pinkmosss/touchsurface_cv/hardware/bom_touch_rack.csv

Designator | Footprint | Quantity | Value | LCSC Part #
CN1 | FPC-SMD_22P-P0.50_FH55-22S-0.5SH | 1 | FH55-22S-0.5SH | C5182313
