pinkmosss/touchsurface_cv/data/test1_summary.csv

condition | n_seconds | mean_fps | std_fps | min_fps | max_fps
untouched | 61 | 50.57377049180328 | 1.81162005208453 | 37 | 51
touched | 61 | 50.36065573770492 | 1.8076945435668967 | 37 | 51
