pinkmosss/touchsurface_cv/data/test1_touched.csv

FPS | 37
FPS | 50
FPS | 50
FPS | 51
FPS | 51
FPS | 51
FPS | 51
FPS | 50
FPS | 50
FPS | 50
FPS | 51
FPS | 51
FPS | 51
FPS | 51
FPS | 50
FPS | 51
FPS | 51
FPS | 51
FPS | 50
FPS | 50
FPS | 50
FPS | 51
FPS | 51
FPS | 51
FPS | 51
FPS | 51
FPS | 50
FPS | 51
FPS | 51
FPS | 51
FPS | 50
FPS | 50
FPS | 50
FPS | 51
FPS | 51
FPS | 51
FPS | 51
FPS | 50
FPS | 50
FPS | 51
FPS | 50
FPS | 51
FPS | 51
FPS | 50
FPS | 50
FPS | 50
FPS | 51
FPS | 51
FPS | 51
FPS | 50
FPS | 50
FPS | 51
FPS | 50
FPS | 51
FPS | 51
FPS | 51
FPS | 50
FPS | 50
FPS | 50
FPS | 51
FPS | 51
