pinkmosss/touchsurface_cv/data/test2_latency.csv

LATENCY_US | 820
LATENCY_US | 812
LATENCY_US | 820
LATENCY_US | 820
LATENCY_US | 820
LATENCY_US | 820
LATENCY_US | 820
LATENCY_US | 816
LATENCY_US | 820
LATENCY_US | 1272
LATENCY_US | 820
LATENCY_US | 816
LATENCY_US | 812
LATENCY_US | 816
LATENCY_US | 816
LATENCY_US | 816
LATENCY_US | 812
LATENCY_US | 820
LATENCY_US | 812
LATENCY_US | 820
LATENCY_US | 1280
LATENCY_US | 816
LATENCY_US | 816
LATENCY_US | 820
LATENCY_US | 820
LATENCY_US | 820
LATENCY_US | 820
LATENCY_US | 820
LATENCY_US | 816
LATENCY_US | 812
LATENCY_US | 820
LATENCY_US | 1268
LATENCY_US | 820
LATENCY_US | 816
LATENCY_US | 1284
LATENCY_US | 976
LATENCY_US | 976
LATENCY_US | 976
LATENCY_US | 976
LATENCY_US | 972
LATENCY_US | 1284
LATENCY_US | 1432
LATENCY_US | 980
LATENCY_US | 976
LATENCY_US | 968
LATENCY_US | 976
LATENCY_US | 976
LATENCY_US | 1288
LATENCY_US | 976
LATENCY_US | 980
LATENCY_US | 980
LATENCY_US | 980
LATENCY_US | 1432
LATENCY_US | 980
LATENCY_US | 1284
LATENCY_US | 1288
LATENCY_US | 976
LATENCY_US | 980
LATENCY_US | 1284
LATENCY_US | 976
LATENCY_US | 1288
LATENCY_US | 980
LATENCY_US | 980
LATENCY_US | 1428
LATENCY_US | 976
LATENCY_US | 980
LATENCY_US | 1288
LATENCY_US | 1292
LATENCY_US | 976
LATENCY_US | 1288
LATENCY_US | 980
LATENCY_US | 980
LATENCY_US | 984
LATENCY_US | 1436
LATENCY_US | 980
LATENCY_US | 980
LATENCY_US | 972
LATENCY_US | 984
LATENCY_US | 980
LATENCY_US | 980
LATENCY_US | 984
LATENCY_US | 1284
LATENCY_US | 976
LATENCY_US | 1292
LATENCY_US | 1432
LATENCY_US | 980
LATENCY_US | 976
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
LATENCY_US | 976
LATENCY_US | 976
LATENCY_US | 972
LATENCY_US | 1436
LATENCY_US | 976
LATENCY_US | 972
LATENCY_US | 972
LATENCY_US | 976
LATENCY_US | 976
LATENCY_US | 976
LATENCY_US | 976
LATENCY_US | 972
LATENCY_US | 972
LATENCY_US | 976
LATENCY_US | 1436
LATENCY_US | 976
LATENCY_US | 976
LATENCY_US | 976
LATENCY_US | 976
LATENCY_US | 972
LATENCY_US | 972
LATENCY_US | 976
LATENCY_US | 972
LATENCY_US | 972
LATENCY_US | 972
LATENCY_US | 1428
LATENCY_US | 976
LATENCY_US | 976
LATENCY_US | 972
LATENCY_US | 972
LATENCY_US | 972
LATENCY_US | 1132
LATENCY_US | 816
LATENCY_US | 816
LATENCY_US | 820
LATENCY_US | 1276
LATENCY_US | 820
LATENCY_US | 820
LATENCY_US | 816
LATENCY_US | 820
LATENCY_US | 812
LATENCY_US | 820
LATENCY_US | 812
LATENCY_US | 820
LATENCY_US | 812
LATENCY_US | 820
LATENCY_US | 1280
LATENCY_US | 816
LATENCY_US | 816
LATENCY_US | 820
LATENCY_US | 820
LATENCY_US | 820
LATENCY_US | 820
LATENCY_US | 816
LATENCY_US | 820
LATENCY_US | 816
LATENCY_US | 820
LATENCY_US | 1272
LATENCY_US | 820
LATENCY_US | 1288
LATENCY_US | 976
LATENCY_US | 980
LATENCY_US | 976
LATENCY_US | 976
LATENCY_US | 980
LATENCY_US | 1292
LATENCY_US | 1292
LATENCY_US | 1436
LATENCY_US | 980
LATENCY_US | 984
LATENCY_US | 972
LATENCY_US | 980
LATENCY_US | 980
