pinkmosss/touchsurface_cv/data/test3_point_bottomleft.csv

TOUCH | 0 | 1
TOUCH | 0 | 1
TOUCH | 0 | 1
TOUCH | 0 | 1
TOUCH | 0 | 1
TOUCH | 0 | 1
TOUCH | 0 | 1
TOUCH | 0 | 1
TOUCH | 0 | 1
TOUCH | 0 | 1
TOUCH | 0 | 1
TOUCH | 0 | 1
