pinkmosss/touchsurface_cv/hardware/component-pad.kicad_pcb

## KiCad design hardware/component-pad.kicad_pcb (2026-09-29)

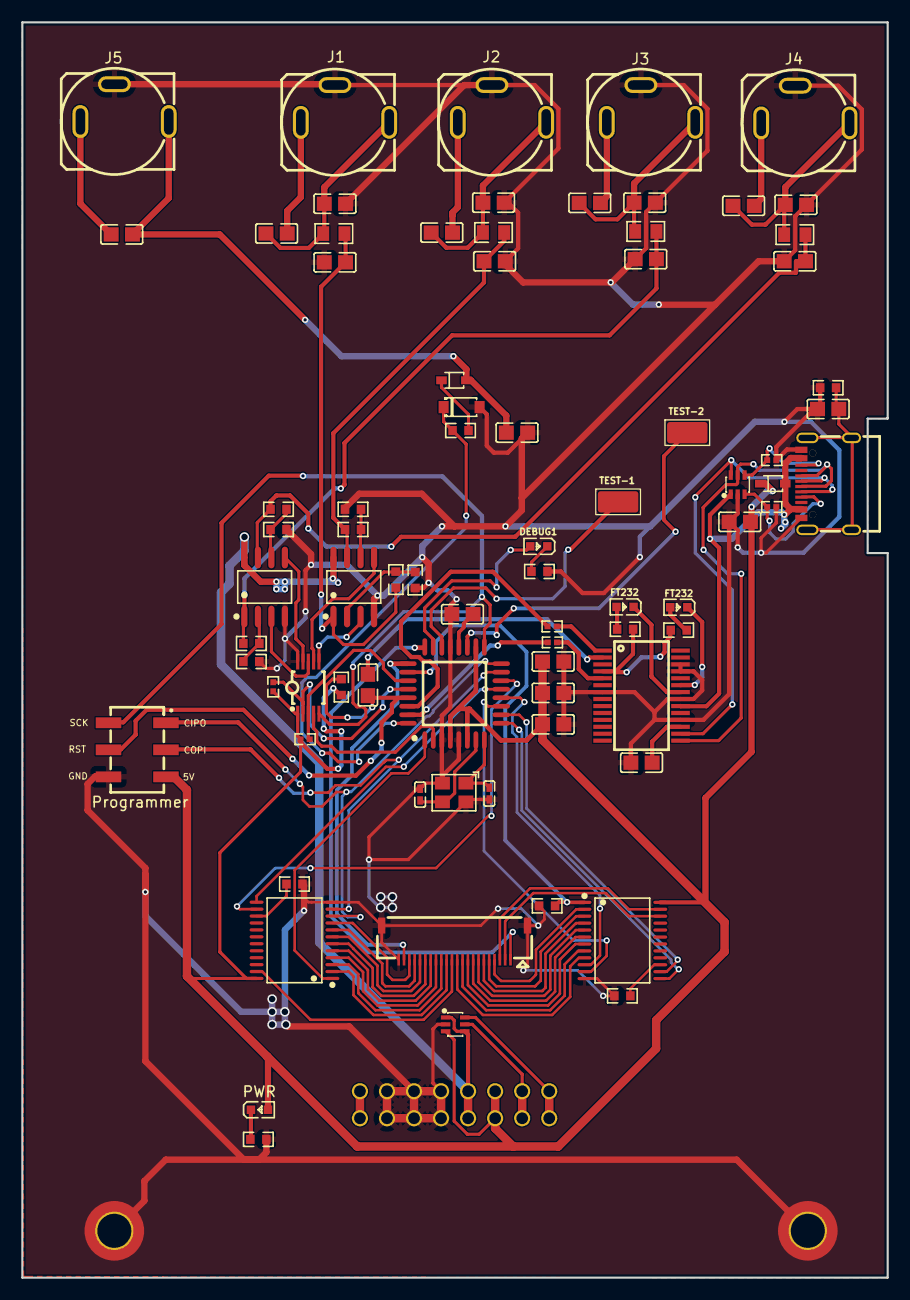
[picture p1: board component-pad.kicad_pcb from above]

Board: 2 copper layers, 81.3 x 117.9 mm, 80 parts (1 on the bottom side), 93 nets.

Parts:
C1, C5, C8, C9, C11, C12, C14, C16, C18, C19, C20, C21, C22, C23, C24: 100nF; C0805
C2, C6, C7, C10, C13, C15, C17: 10uF; C0805
C3, C4: 15pf; C0402
CN1: FH55-22S-0.5SH; FPC-SMD_22P-P0.50_FH55-22S-0.5SH
CN2: PM254-2-03-S-8.5; HDR-SMD_6P-P2.54-V-F-R2-C3-LS7.0
D1, D2: SMF05CT1G; SOT-363_L2.0-W1.3-P0.65-LS2.1-BR
D3, D4: 1N5819WS; SOD-323_L1.8-W1.3-LS2.5-RD
J1, J2, J3, J4, J5: PJ-3411; AUDIO-TH_PJ-3411
LED1, LED2: Red; LED0603-RD
LED3, LED4: KT-0603R; LED0603-RD
P1: Eurorack Power; IDC-TH_16P-P2.54_C3406
R1: 1M; R0603
R2, R3: 5.1k; R0402
R4, R5, R30, R31: 330; R0603
R6, R9, R10, R11, R12, R13, R14, R15, R16, R17, R18, R24: 10k; R0603
R7, R8: 4.7k; R0402
R19, R20, R21, R22: 100; R0805
R27, R28: 1k; R0402
R29: 100k; R0603
TEST-1, TEST-2: TestPoint_Keystone_5019_Miniature
U1: MCP4728-E/UN; MSOP-10_L3.0-W3.0-P0.50-LS5.0-TL
U2: ATMEGA328-AU; TQFP-32_L7.0-W7.0-P0.80-LS9.0-BL
U3: FT232RNL-REEL; SSOP28_L10.2-W5.3-P0.65-LS7.8-BL
U4, U5: CD74HC4067SM96; SSOP-24_L8.1-W5.3-P0.65-LS7.8-BL
U6, U7: MCP6002T-I/SN; SOIC-8_L4.9-W3.9-P1.27-LS6.0-BL
USB1: TYPE-C16PIN; USB-C-SMD_TYPE-C16PIN
X1: X322516MLB4SI; OSC-SMD_4P-L3.2-W2.5-BL
ZD1: BZT52C5V1; SOD-123_L2.8-W1.8-LS3.7-RD

Connections:
AVR_RST: C5.1, CN2.5, R6.1, U2.29 (~PC6(RESET/PCINT14))
CAP1: CN1.1, U2.24 (PC1(ADC1/PCINT9))
CAP2: CN1.21, U2.25 (PC2(ADC2/PCINT10))
CC_1: D1.3, R3.1, USB1.A5 (CC1)
CC_2: D1.4, R2.1, USB1.B5 (CC2)
CIPO: CN2.1, U2.16 ((PCINT4/MISO)PB4), U4.10 (S0)
COPI: CN2.2, U2.15 ((PCINT3/OC2A/MOSI)PB3), U4.11 (S1)
DAC_LDAC: U1.4 (~LDAC), U2.2 ((PCINT20/XCK/T0)PD4)
DAC_OUT1: U1.6 (VOUTA), U6.3 (+INA)
DAC_OUT2: U1.7 (VOUTB), U6.5 (+INB)
DAC_OUT3: U1.8 (VOUTC), U7.3 (+INA)
DAC_OUT4: U1.9 (VOUTD), U7.5 (+INB)
DAC_RDY: CN2.6, U1.5 (RDY/~BSY), U2.17 (PB5(SCK/PCINT5))
DAC_SCL: R7.1, U1.2 (SCL), U2.28 (PC5(ADC5/SCL/PCINT13))
DAC_SDA: R8.1, U1.3 (SDA), U2.27 (PC4(ADC4/SDA/PCINT12))
DBUG1: LED4.2 (A), U2.23 (PC0(ADC0/PCINT8))
ER_CV: D2.5, P1.13, P1.14
ER_GATE: D2.6, P1.15, P1.16
ER_NEG_12V: P1.1, P1.2
ER_POS_5V: C2.1, C6.2, C7.2, C8.2, CN2.3, D2.3, D3.1 (K), LED3.2 (A), P1.11, P1.12, R6.2, R7.2, R8.2, U1.1 (VDD), U2.4 (VCC), U2.6 (VCC), U2.18 (AVCC), U4.24 (VCC), U5.24 (VCC)
ER_POS_12V: D2.1, D2.4, P1.9, P1.10, U6.8 (VDD), U7.8 (VDD)
FT_DTR: C5.2, U3.2 (~DTR)
FT_RXD: R28.1, U2.31 (PD1(TXD/PCINT17))
FT_TXD: R27.1, U2.30 (PD0(RXD/PCINT16))
FT_VCCIO: R30.2, R31.2, U3.4 (VCCIO)
GND: C1.2, C2.2, C3.1, C4.1, C6.1, C7.1, C8.1, C9.2, C10.2, C11.2, C12.2, C13.2, C14.2, C15.2, C16.2, C17.2, C18.2, C19.1, CN1.0, CN1.22, CN2.4, D1.2, D2.2, J1.5, J2.5, J3.5, J4.5, J5.5, P1.3, P1.4, P1.5, P1.6, P1.7, P1.8, R1.1, R2.2, R3.2, R4.1, R5.1, R9.2, R10.2, R12.1, R14.1, R16.1, R18.1, R29.2, U1.10 (VSS), U2.3 (GND), U2.5 (GND), U2.21 (GND), U3.7 (GND), U3.18 (GND), U3.21 (GND), U3.25 (AGND), U3.26 (TEST), U4.12 (GND), U5.12 (GND), U6.4 (-VSS), U7.4 (-VSS), USB1.A1B12 (GND), USB1.B1A12 (GND), X1.2 (GND), X1.4 (GND), ZD1.2 (A)
unnamed: C1.1, R1.2, USB1.1 (SHELL), USB1.2 (SHELL), USB1.3 (SHELL), USB1.4 (SHELL)
unnamed: C11.1, C20.1, J2.3, R19.1
unnamed: C12.1, C21.1, J1.3, R20.1
unnamed: C14.1, C23.1, J3.3, R21.1
unnamed: C16.1, C22.1, J4.3, R22.1
unnamed: C20.2, J2.2
unnamed: C21.2, J1.2
unnamed: C22.2, J4.2
unnamed: C23.2, J3.2
unnamed: C24.2, J5.2
unnamed: C18.1, C24.1, D4.2 (A), J5.3
unnamed: D4.1 (K), R24.2
unnamed: LED1.2 (A), R31.1
unnamed: LED1.1 (K), U3.22 (CBUS1)
unnamed: LED2.2 (A), R30.1
unnamed: LED2.1 (K), U3.23 (CBUS0)
unnamed: LED3.1 (K), R4.2
unnamed: LED4.1 (K), R5.2
unnamed: C3.2, U2.7 ((PCINT6/XTAL1/TOSC1)PB6), X1.3 (OSC2)
unnamed: C4.2, U2.8 ((PCINT7/XTAL2/TOSC2)PB7), X1.1 (OSC1)
unnamed: C9.1, U2.20 (AREF)
unnamed: C19.2, U3.17 (3V3OUT)
unnamed: R28.2, U3.5 (RXD)
unnamed: R27.2, U3.1 (TXD)
unnamed: R9.1, U4.15 (~E)
unnamed: R10.1, U5.15 (~E)
unnamed: R11.2, R12.2, U6.2 (-INA)
unnamed: R13.1, R14.2, U6.6 (-INB)
unnamed: R15.2, R16.2, U7.2 (-INA)
unnamed: R17.1, R18.2, U7.6 (-INB)
OUT1: C10.1, R11.1, R20.2, U6.1 (OUTA)
OUT2: C13.1, R13.2, R19.2, U6.7 (OUTB)
OUT3: C15.1, R15.1, R21.2, U7.1 (OUTA)
OUT4: C17.1, R17.2, R22.2, U7.7 (OUTB)
RX_ADC: R29.1, U2.26 (PC3(ADC3/PCINT11)), U5.1 (COMMONINOUT/OUTPUT)
RX_SEL0: U2.12 ((PCINT0/CLKO/ICP1)PB0), U5.10 (S0)
RX_SEL1: U2.11 ((PCINT23/AIN1)PD7), U5.11 (S1)
RX_SEL2: U2.10 ((PCINT22/OC0A/AIN0)PD6), U5.14 (S2)
RX_SEL3: U2.9 ((PCINT21/OC0B/T1)PD5), U5.13 (S3)
RX_SIGNAL_0: CN1.11, U5.9 (I0)
RX_SIGNAL_1: CN1.10, U5.8 (I1)
RX_SIGNAL_2: CN1.9, U5.7 (I2)
RX_SIGNAL_3: CN1.8, U5.6 (I3)
RX_SIGNAL_4: CN1.7, U5.5 (I4)
RX_SIGNAL_5: CN1.6, U5.4 (I5)
RX_SIGNAL_6: CN1.5, U5.3 (I6)
RX_SIGNAL_7: CN1.4, U5.2 (I7)
RX_SIGNAL_8: CN1.3, U5.23 (I8)
RX_SIGNAL_9: CN1.2, U5.22 (I9)
TEST1: TEST-1.1, U2.22 (ADC7)
TEST2: TEST-2.1, U2.19 (ADC6)
TRIG: R24.1, U2.32 (PD2(INT0/PCINT18)), ZD1.1 (K)
TX_PWM: U2.1 ((PCINT19/OC2B/INT1)PD3), U4.1 (COMMONINOUT/OUTPUT)
TX_SEL2: U2.14 ((PCINT2/SS/OC1B)PB2), U4.14 (S2)
TX_SEL3: U2.13 ((PCINT1/OC1A)PB1), U4.13 (S3)
TX_SIGNAL_0: CN1.20, U4.9 (I0)
TX_SIGNAL_1: CN1.19, U4.8 (I1)
TX_SIGNAL_2: CN1.18, U4.7 (I2)
TX_SIGNAL_3: CN1.17, U4.6 (I3)
TX_SIGNAL_4: CN1.16, U4.5 (I4)
TX_SIGNAL_5: CN1.15, U4.4 (I5)
TX_SIGNAL_6: CN1.14, U4.3 (I6)
TX_SIGNAL_7: CN1.13, U4.2 (I7)
TX_SIGNAL_8: CN1.12, U4.23 (I8)
USB_DN: D1.6, U3.16 (USBDM), USB1.A7 (DN1), USB1.B7 (DN2)
USB_DP: D1.5, U3.15 (USBDP), USB1.A6 (DP1), USB1.B6 (DP2)
VBUS: D1.1, D3.2 (A), U3.20 (VCC), USB1.A4B9 (VBUS), USB1.B4A9 (VBUS)
